andrewvh4/GPSClock_Hardware/README.md

# GPSClock_Hardware
A modular design for a GPS clock featuring a processor board to recieve and parse GPS data, and a display board to output the time.
