andrewvh4/GPSClock_Hardware/Documentation/Schematics/Binary Display Schematic.pdf

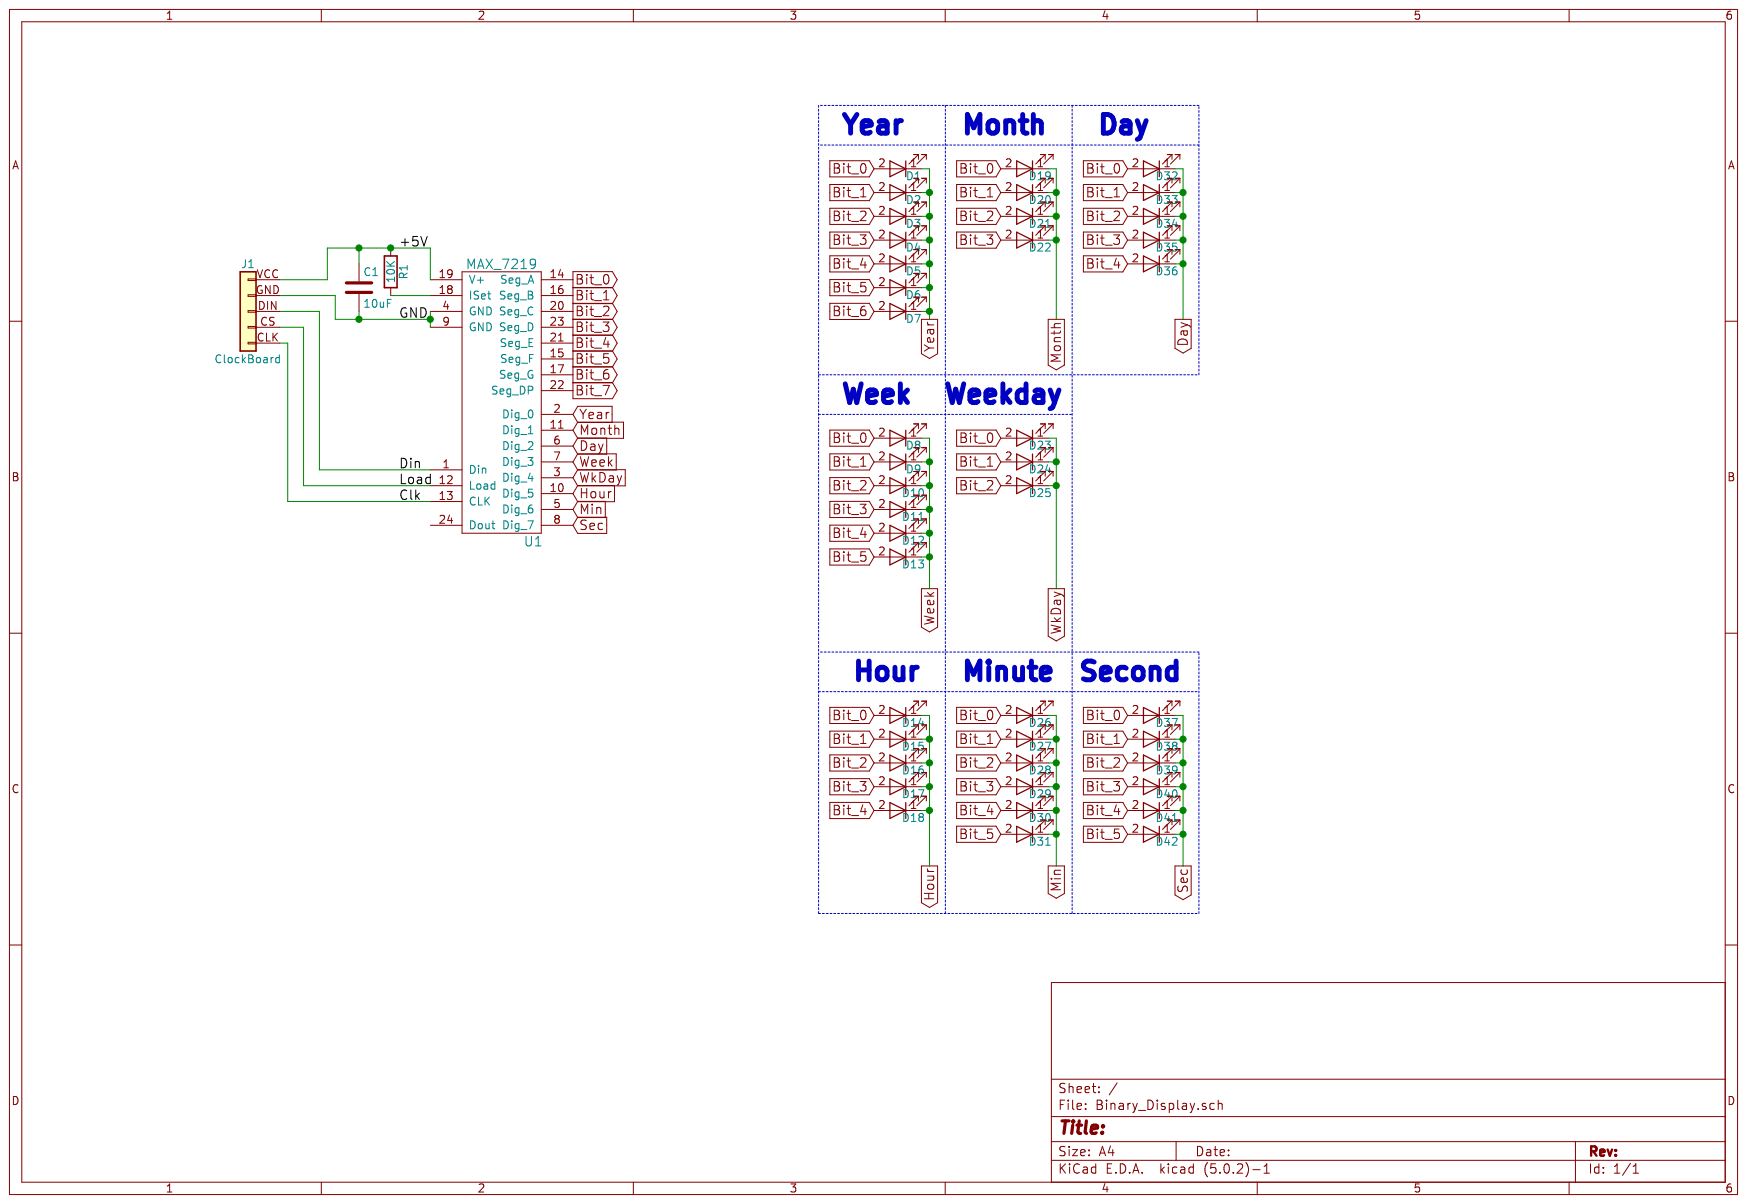
[picture p1: page 1]
