andrewvh4/GPSClock_Hardware/Documentation/Schematics/Clock Board Schematic.pdf

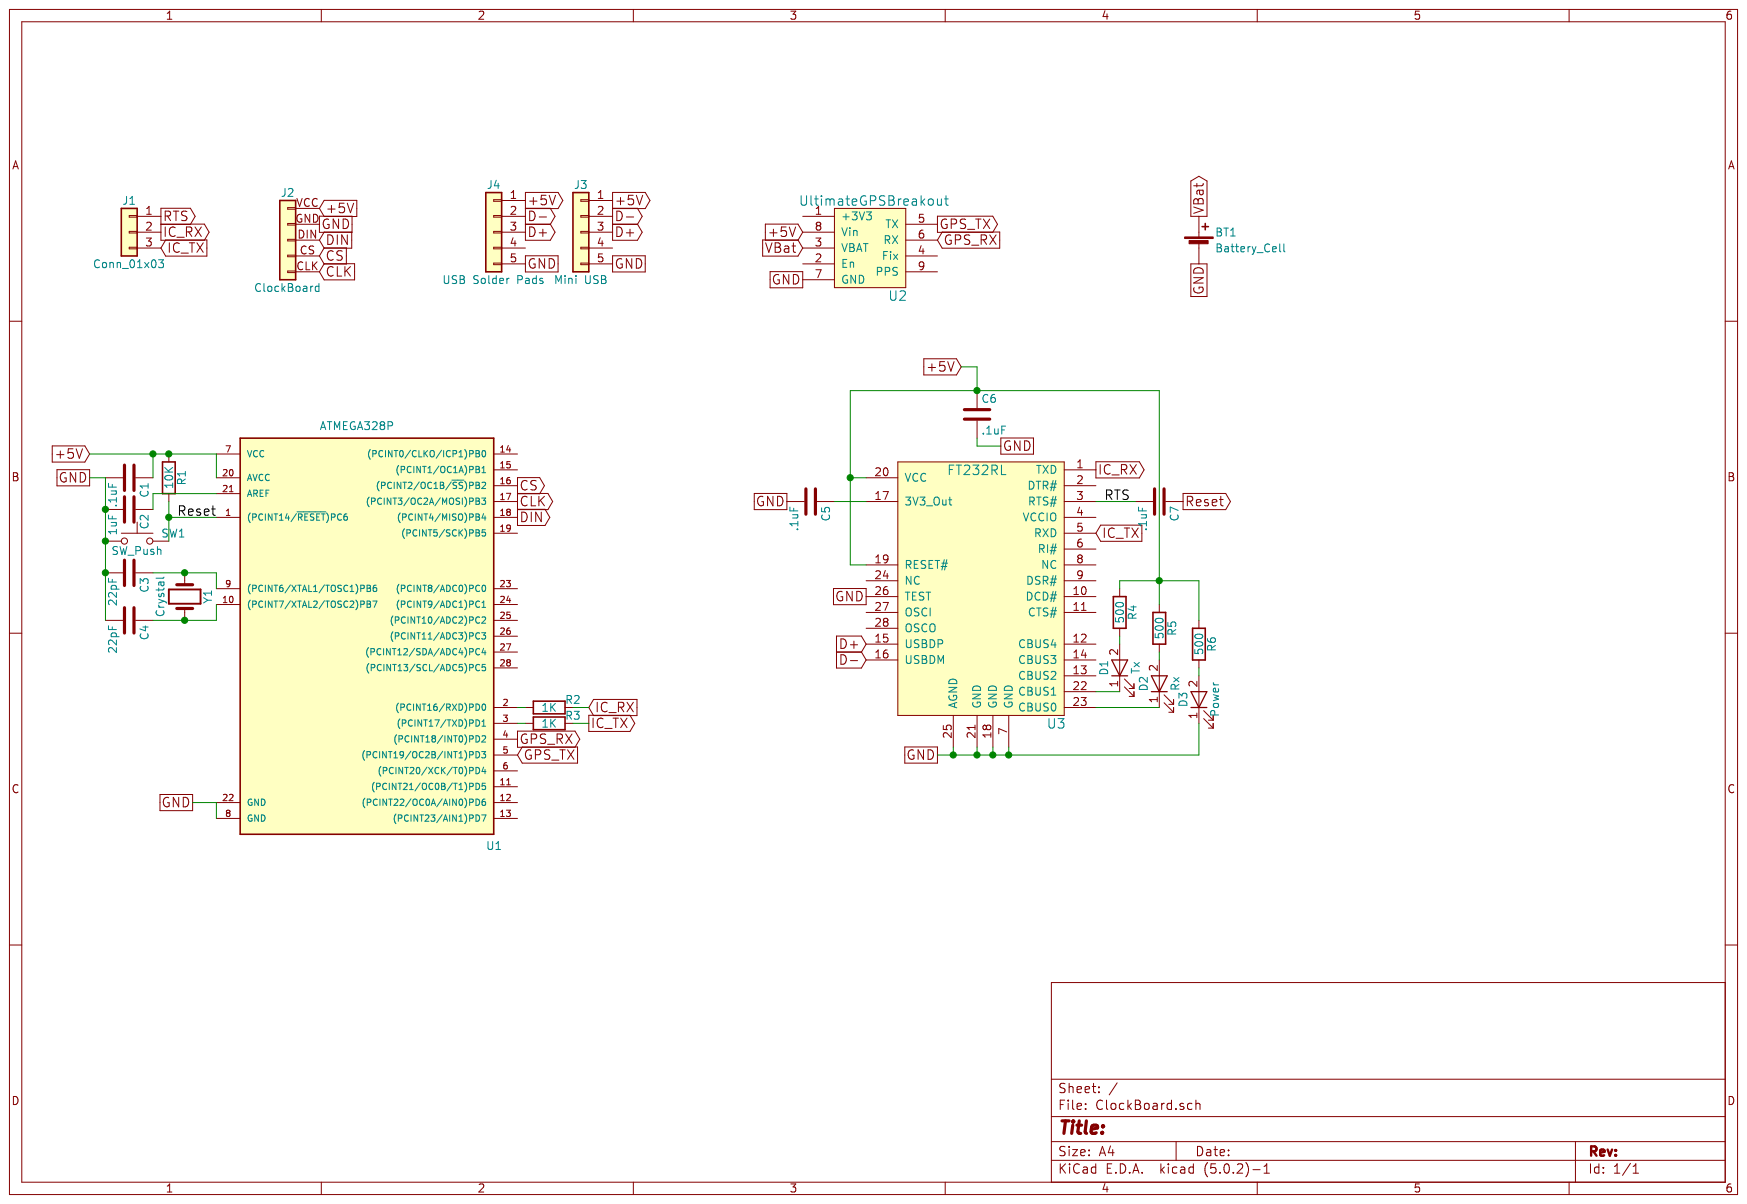
[picture p2: page 1]
