andrewvh4/GPSClock_Hardware/Documentation/Schematics/Conventional Display Schematic.pdf

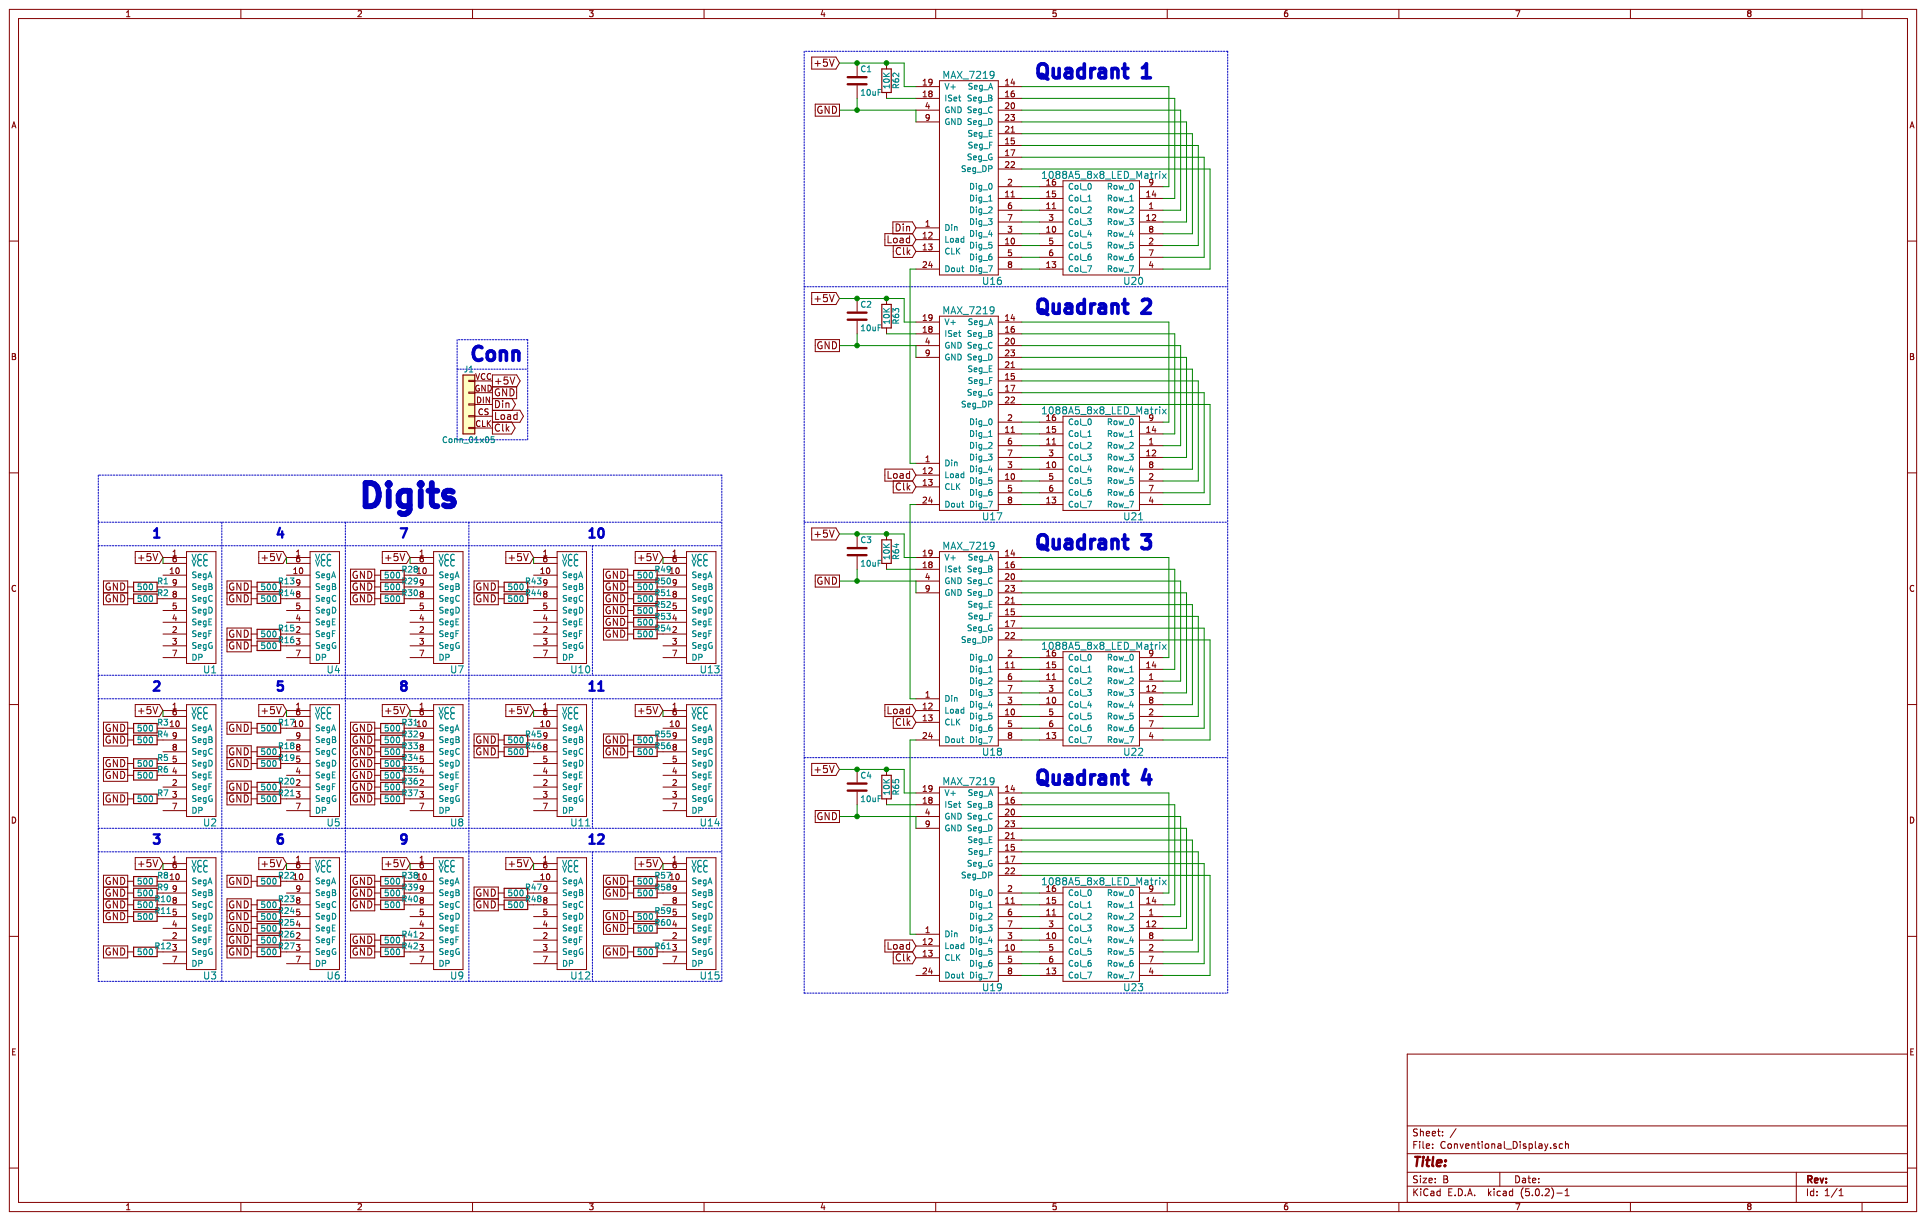
[picture p3: page 1]
