andrewvh4/GPSClock_Hardware/Conventional_Display/Conventional_Display.kicad_pcb

## KiCad design Conventional_Display/Conventional_Display.kicad_pcb (2020-06-09)

Schematic: Conventional_Display.sch

Parts:
C1, C2, C3, C4: 10uF; C_0603_HandSoldering
J1: Conn_01x05; Clock_Board
R1, R2, R3, R4, R5, R6, R7, R8, R9, R10, R11, R12, R13, R14, R15, R16, R17, R18, R19, R20, R21, R22, R23, R24, R25, R26, R27, R28, R29, R30, R31, R32, R33, R34, R35, R36, R37, R38, R39, R40, R41, R42, R43, R44, R45, R46, R47, R48, R49, R50, R51, R52, R53, R54, R55, R56, R57, R58, R59, R60, R61: 500; R_0603_HandSoldering
R62, R63, R64, R65: 10K; R_0603_HandSoldering
U1, U2, U3, U4, U5, U6, U7, U8, U9, U10, U11, U12, U13, U14, U15: 7-Segment_Display_CA; LSH-A101
U16, U17, U18, U19: MAX_7219; SOIC-24W_7.5x15.4mm_Pitch1.27mm
U20, U21, U22, U23: 1088A5_8x8_LED_Matrix; 1088A5_8x8matrix

Connections:
+5V: C1.1, C2.1, C3.1, C4.1, J1.VCC, R62.1, R63.1, R64.1, R65.1, U1.1, U1.6, U2.1, U2.6, U3.1, U3.6, U4.1, U4.6, U5.1, U5.6, U6.1, U6.6, U7.1, U7.6, U8.1, U8.6, U9.1, U9.6, U10.1, U10.6, U11.1, U11.6, U12.1, U12.6, U13.1, U13.6, U14.1, U14.6, U15.1, U15.6, U16.19 (V+), U17.19 (V+), U18.19 (V+), U19.19 (V+)
Clk: J1.CLK, U16.13 (CLK), U17.13 (CLK), U18.13 (CLK), U19.13 (CLK)
Din: J1.DIN, U16.1 (Din)
GND: C1.2, C2.2, C3.2, C4.2, J1.GND, R1.2, R2.2, R3.2, R4.2, R5.2, R6.2, R7.2, R8.2, R9.2, R10.2, R11.2, R12.2, R13.2, R14.2, R15.2, R16.2, R17.2, R18.2, R19.2, R20.2, R21.2, R22.2, R23.2, R24.2, R25.2, R26.2, R27.2, R28.2, R29.2, R30.2, R31.2, R32.2, R33.2, R34.2, R35.2, R36.2, R37.2, R38.2, R39.2, R40.2, R41.2, R42.2, R43.2, R44.2, R45.2, R46.2, R47.2, R48.2, R49.2, R50.2, R51.2, R52.2, R53.2, R54.2, R55.2, R56.2, R57.2, R58.2, R59.2, R60.2, R61.2, U16.4 (GND), U16.9 (GND), U17.4 (GND), U17.9 (GND), U18.4 (GND), U18.9 (GND), U19.4 (GND), U19.9 (GND)
Load: J1.CS, U16.12 (Load), U17.12 (Load), U18.12 (Load), U19.12 (Load)
unnamed: R1.1, U1.9
unnamed: R2.1, U1.8
unnamed: R3.1, U2.10
unnamed: R4.1, U2.9
unnamed: R5.1, U2.5
unnamed: R6.1, U2.4
unnamed: R7.1, U2.3
unnamed: R8.1, U3.10
unnamed: R9.1, U3.9
unnamed: R10.1, U3.8
unnamed: R11.1, U3.5
unnamed: R12.1, U3.3
unnamed: R13.1, U4.9
unnamed: R14.1, U4.8
unnamed: R15.1, U4.2
unnamed: R16.1, U4.3
unnamed: R17.1, U5.10
unnamed: R18.1, U5.8
unnamed: R19.1, U5.5
unnamed: R20.1, U5.2
unnamed: R21.1, U5.3
unnamed: R22.1, U6.10
unnamed: R23.1, U6.8
unnamed: R24.1, U6.5
unnamed: R25.1, U6.4
unnamed: R26.1, U6.2
unnamed: R27.1, U6.3
unnamed: R28.1, U7.10
unnamed: R29.1, U7.9
unnamed: R30.1, U7.8
unnamed: R31.1, U8.10
unnamed: R32.1, U8.9
unnamed: R33.1, U8.8
unnamed: R34.1, U8.5
unnamed: R35.1, U8.4
unnamed: R36.1, U8.2
unnamed: R37.1, U8.3
unnamed: R38.1, U9.10
unnamed: R39.1, U9.9
unnamed: R40.1, U9.8
unnamed: R41.1, U9.2
unnamed: R42.1, U9.3
unnamed: R43.1, U10.9
unnamed: R44.1, U10.8
unnamed: R45.1, U11.9
unnamed: R46.1, U11.8
unnamed: R47.1, U12.9
unnamed: R48.1, U12.8
unnamed: R49.1, U13.10
unnamed: R50.1, U13.9
unnamed: R51.1, U13.8
unnamed: R52.1, U13.5
unnamed: R53.1, U13.4
unnamed: R54.1, U13.2
unnamed: R55.1, U14.9
unnamed: R56.1, U14.8
unnamed: R57.1, U15.10
unnamed: R58.1, U15.9
unnamed: R59.1, U15.5
unnamed: R60.1, U15.4
unnamed: R61.1, U15.3
unnamed: R62.2, U16.18 (ISet)
unnamed: R63.2, U17.18 (ISet)
unnamed: R64.2, U18.18 (ISet)
unnamed: R65.2, U19.18 (ISet)
unnamed: U16.2 (Dig_0), U20.1 (Row_0)
unnamed: U16.3 (Dig_4), U20.9 (Row_4)
unnamed: U16.5 (Dig_6), U20.10 (Row_6)
unnamed: U16.6 (Dig_2), U20.16 (Row_2)
unnamed: U16.7 (Dig_3), U20.4 (Row_3)
unnamed: U16.8 (Dig_7), U20.13 (Row_7)
unnamed: U16.10 (Dig_5), U20.15 (Row_5)
unnamed: U16.11 (Dig_1), U20.6 (Row_1)
unnamed: U16.14 (Seg_A), U20.11 (Col_1)
unnamed: U16.15 (Seg_F), U20.7 (Col_6)
unnamed: U16.16 (Seg_B), U20.12 (Col_2)
unnamed: U16.17 (Seg_G), U20.8 (Col_7)
unnamed: U16.20 (Seg_C), U20.2 (Col_3)
unnamed: U16.21 (Seg_E), U20.3 (Col_5)
unnamed: U16.22 (Seg_DP), U20.5 (Col_0)
unnamed: U16.23 (Seg_D), U20.14 (Col_4)
unnamed: U16.24 (Dout), U17.1 (Din)
unnamed: U17.2 (Dig_0), U21.1 (Row_0)
unnamed: U17.3 (Dig_4), U21.9 (Row_4)
unnamed: U17.5 (Dig_6), U21.10 (Row_6)
unnamed: U17.6 (Dig_2), U21.16 (Row_2)
unnamed: U17.7 (Dig_3), U21.4 (Row_3)
unnamed: U17.8 (Dig_7), U21.13 (Row_7)
unnamed: U17.10 (Dig_5), U21.15 (Row_5)
unnamed: U17.11 (Dig_1), U21.6 (Row_1)
unnamed: U17.14 (Seg_A), U21.11 (Col_1)
unnamed: U17.15 (Seg_F), U21.7 (Col_6)
unnamed: U17.16 (Seg_B), U21.12 (Col_2)
unnamed: U17.17 (Seg_G), U21.8 (Col_7)
unnamed: U17.20 (Seg_C), U21.2 (Col_3)
unnamed: U17.21 (Seg_E), U21.3 (Col_5)
unnamed: U17.22 (Seg_DP), U21.5 (Col_0)
unnamed: U17.23 (Seg_D), U21.14 (Col_4)
unnamed: U17.24 (Dout), U18.1 (Din)
unnamed: U18.2 (Dig_0), U22.1 (Row_0)
unnamed: U18.3 (Dig_4), U22.9 (Row_4)
unnamed: U18.5 (Dig_6), U22.10 (Row_6)
unnamed: U18.6 (Dig_2), U22.16 (Row_2)
unnamed: U18.7 (Dig_3), U22.4 (Row_3)
unnamed: U18.8 (Dig_7), U22.13 (Row_7)
unnamed: U18.10 (Dig_5), U22.15 (Row_5)
unnamed: U18.11 (Dig_1), U22.6 (Row_1)
unnamed: U18.14 (Seg_A), U22.11 (Col_1)
unnamed: U18.15 (Seg_F), U22.7 (Col_6)
unnamed: U18.16 (Seg_B), U22.12 (Col_2)
unnamed: U18.17 (Seg_G), U22.8 (Col_7)
unnamed: U18.20 (Seg_C), U22.2 (Col_3)
unnamed: U18.21 (Seg_E), U22.3 (Col_5)
unnamed: U18.22 (Seg_DP), U22.5 (Col_0)
unnamed: U18.23 (Seg_D), U22.14 (Col_4)
unnamed: U18.24 (Dout), U19.1 (Din)
unnamed: U19.2 (Dig_0), U23.1 (Row_0)
unnamed: U19.3 (Dig_4), U23.9 (Row_4)
unnamed: U19.5 (Dig_6), U23.10 (Row_6)
unnamed: U19.6 (Dig_2), U23.16 (Row_2)
unnamed: U19.7 (Dig_3), U23.4 (Row_3)
unnamed: U19.8 (Dig_7), U23.13 (Row_7)
unnamed: U19.10 (Dig_5), U23.15 (Row_5)
unnamed: U19.11 (Dig_1), U23.6 (Row_1)
unnamed: U19.14 (Seg_A), U23.11 (Col_1)
unnamed: U19.15 (Seg_F), U23.7 (Col_6)
unnamed: U19.16 (Seg_B), U23.12 (Col_2)
unnamed: U19.17 (Seg_G), U23.8 (Col_7)
unnamed: U19.20 (Seg_C), U23.2 (Col_3)
unnamed: U19.21 (Seg_E), U23.3 (Col_5)
unnamed: U19.22 (Seg_DP), U23.5 (Col_0)
unnamed: U19.23 (Seg_D), U23.14 (Col_4)

Notes on the sheet:
Quadrant 1
Quadrant 2
Quadrant 3
Quadrant 4
Digits
Conn

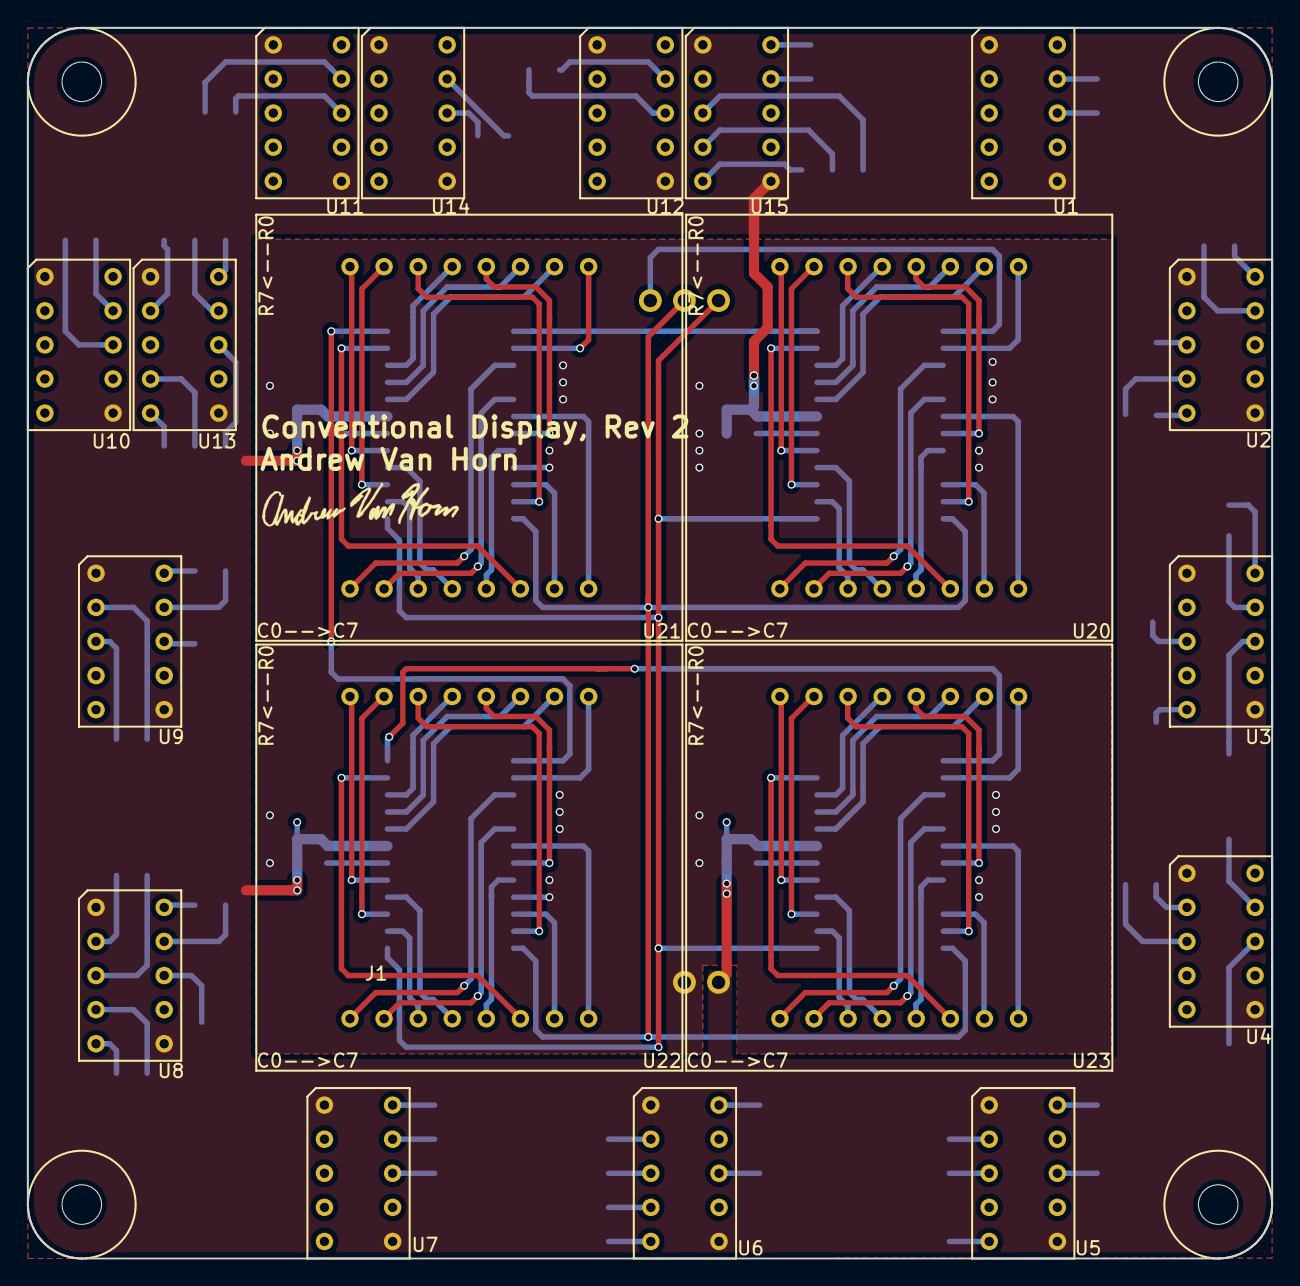
[picture p4: board Conventional_Display.kicad_pcb from above]

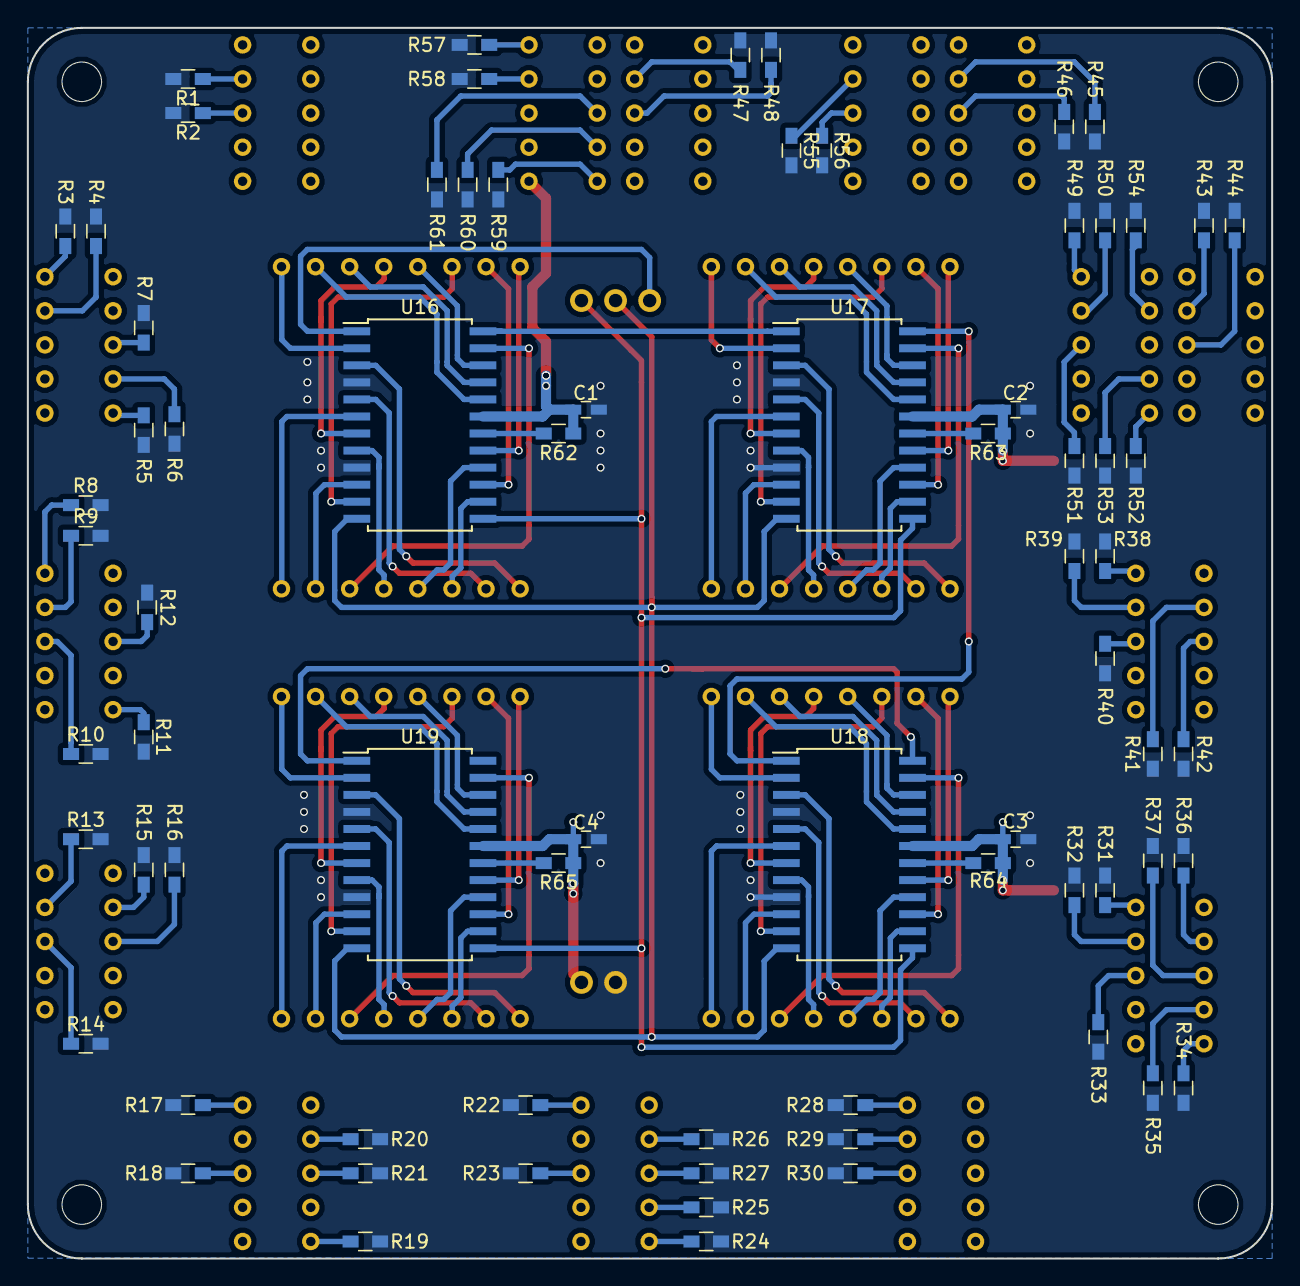
[picture p5: board Conventional_Display.kicad_pcb from below]

Board: 2 copper layers, 92.7 x 91.7 mm, 93 parts (73 on the bottom side), 137 nets.
