andrewvh4/GPSClock_Hardware/Binary_Display/Binary_Display.kicad_pcb

## KiCad design Binary_Display/Binary_Display.kicad_pcb (2020-06-01)

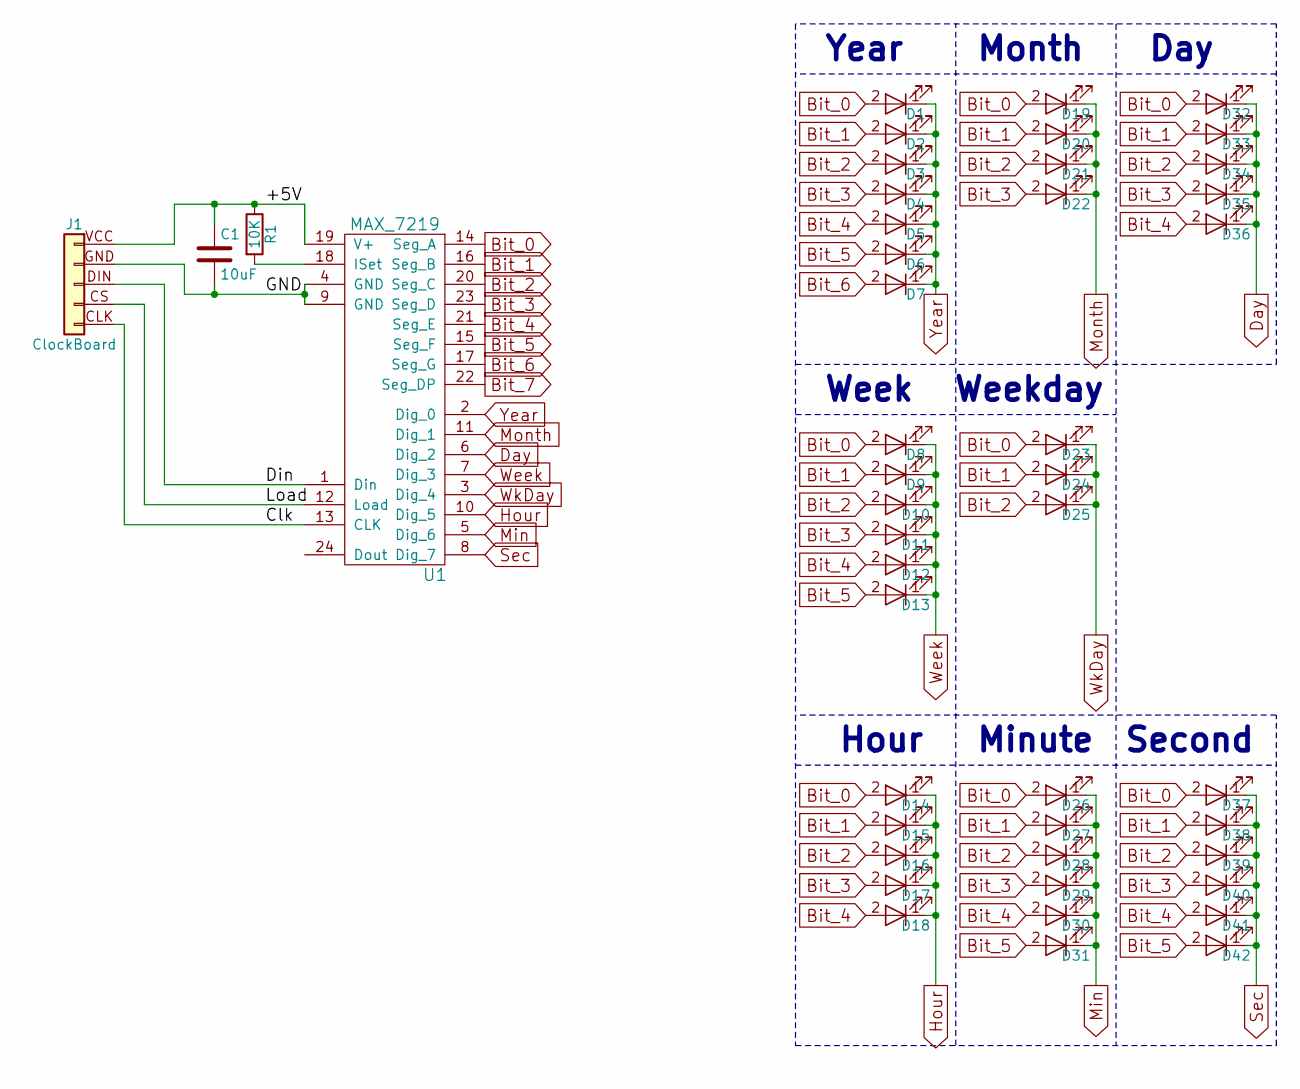
[picture p6: schematic Binary_Display.sch]

Parts:
C1: 10uF; C_0603_HandSoldering
D1, D2, D3, D4, D5, D6, D7, D8, D9, D10, D11, D12, D13, D14, D15, D16, D17, D18, D19, D20, D21, D22, D23, D24, D25, D26, D27, D28, D29, D30, D31, D32, D33, D34, D35, D36, D37, D38, D39, D40, D41, D42: LED; LED_D5.0mm
J1: ClockBoard; Clock_Board
R1: 10K; R_0603_HandSoldering
U1: MAX_7219; SOIC-24W_7.5x15.4mm_Pitch1.27mm

Connections:
/+5V: C1.1, J1.VCC (Pin_1), R1.1, U1.19 (V+)
/Clk: J1.CLK (Pin_5), U1.13 (CLK)
/Din: J1.DIN (Pin_3), U1.1 (Din)
/GND: C1.2, J1.GND (Pin_2), U1.4 (GND), U1.9 (GND)
/Load: J1.CS (Pin_4), U1.12 (Load)
Bit_0: D1.2 (A), D8.2 (A), D14.2 (A), D19.2 (A), D23.2 (A), D26.2 (A), D32.2 (A), D37.2 (A), U1.14 (Seg_A)
Bit_1: D2.2 (A), D9.2 (A), D15.2 (A), D20.2 (A), D24.2 (A), D27.2 (A), D33.2 (A), D38.2 (A), U1.16 (Seg_B)
Bit_2: D3.2 (A), D10.2 (A), D16.2 (A), D21.2 (A), D25.2 (A), D28.2 (A), D34.2 (A), D39.2 (A), U1.20 (Seg_C)
Bit_3: D4.2 (A), D11.2 (A), D17.2 (A), D22.2 (A), D29.2 (A), D35.2 (A), D40.2 (A), U1.23 (Seg_D)
Bit_4: D5.2 (A), D12.2 (A), D18.2 (A), D30.2 (A), D36.2 (A), D41.2 (A), U1.21 (Seg_E)
Bit_5: D6.2 (A), D13.2 (A), D31.2 (A), D42.2 (A), U1.15 (Seg_F)
Bit_6: D7.2 (A), U1.17 (Seg_G)
Day: D32.1 (K), D33.1 (K), D34.1 (K), D35.1 (K), D36.1 (K), U1.6 (Dig_2)
Hour: D14.1 (K), D15.1 (K), D16.1 (K), D17.1 (K), D18.1 (K), U1.10 (Dig_5)
Min: D26.1 (K), D27.1 (K), D28.1 (K), D29.1 (K), D30.1 (K), D31.1 (K), U1.5 (Dig_6)
Month: D19.1 (K), D20.1 (K), D21.1 (K), D22.1 (K), U1.11 (Dig_1)
unnamed: R1.2, U1.18 (ISet)
Sec: D37.1 (K), D38.1 (K), D39.1 (K), D40.1 (K), D41.1 (K), D42.1 (K), U1.8 (Dig_7)
Week: D8.1 (K), D9.1 (K), D10.1 (K), D11.1 (K), D12.1 (K), D13.1 (K), U1.7 (Dig_3)
WkDay: D23.1 (K), D24.1 (K), D25.1 (K), U1.3 (Dig_4)
Year: D1.1 (K), D2.1 (K), D3.1 (K), D4.1 (K), D5.1 (K), D6.1 (K), D7.1 (K), U1.2 (Dig_0)

Notes on the sheet:
Year
Month
Day
Week
Weekday
Hour
Minute
Second

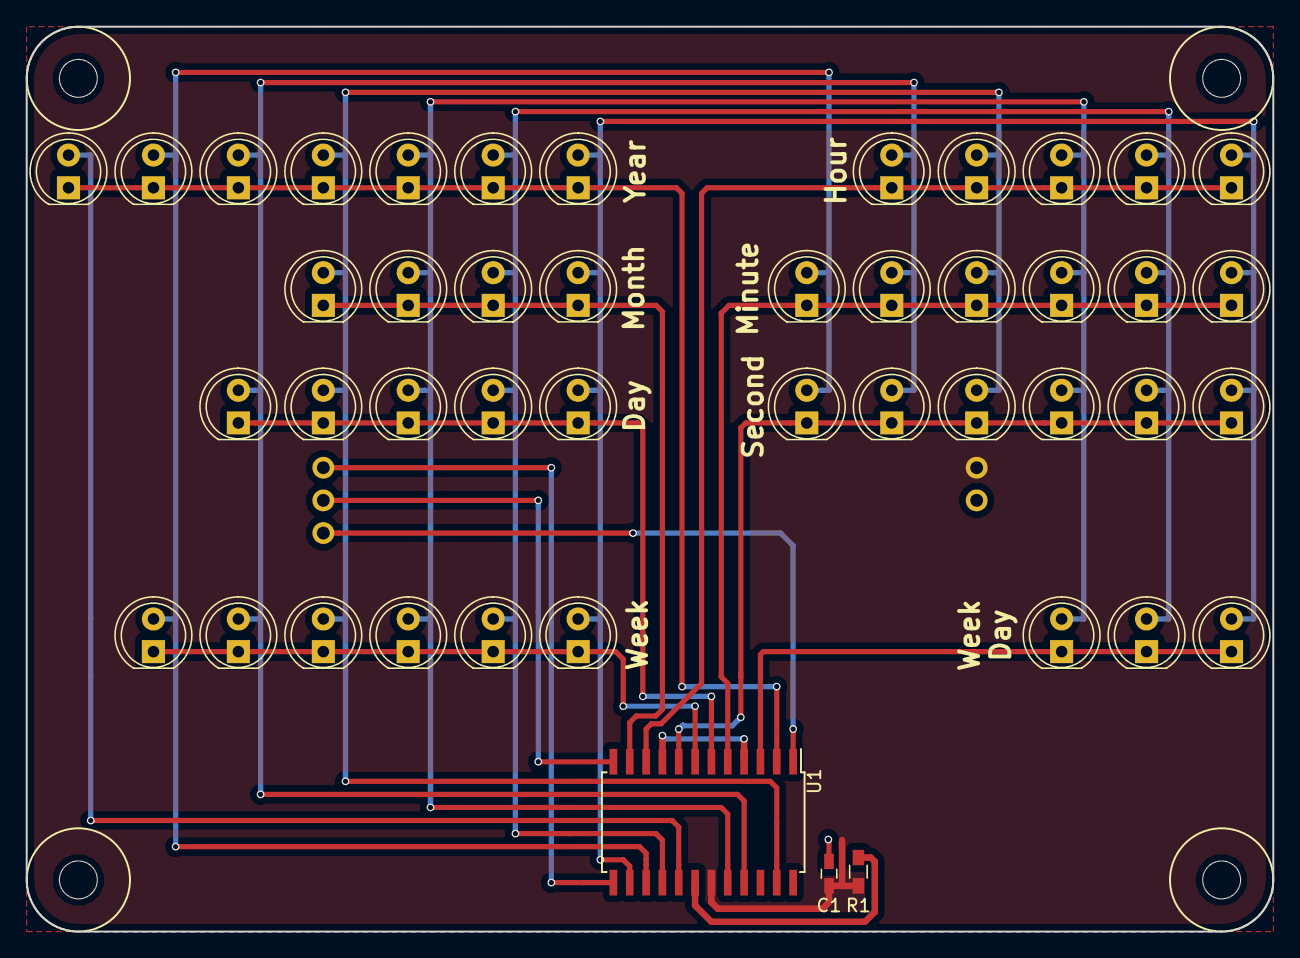
[picture p7: board Binary_Display.kicad_pcb from above]

Board: 2 copper layers, 96.9 x 70.4 mm, 46 parts (0 on the bottom side), 21 nets.
