andrewvh4/GPSClock_Hardware/ClockBoard/ClockBoard.kicad_pcb

## KiCad design ClockBoard/ClockBoard.kicad_pcb (2020-06-01)

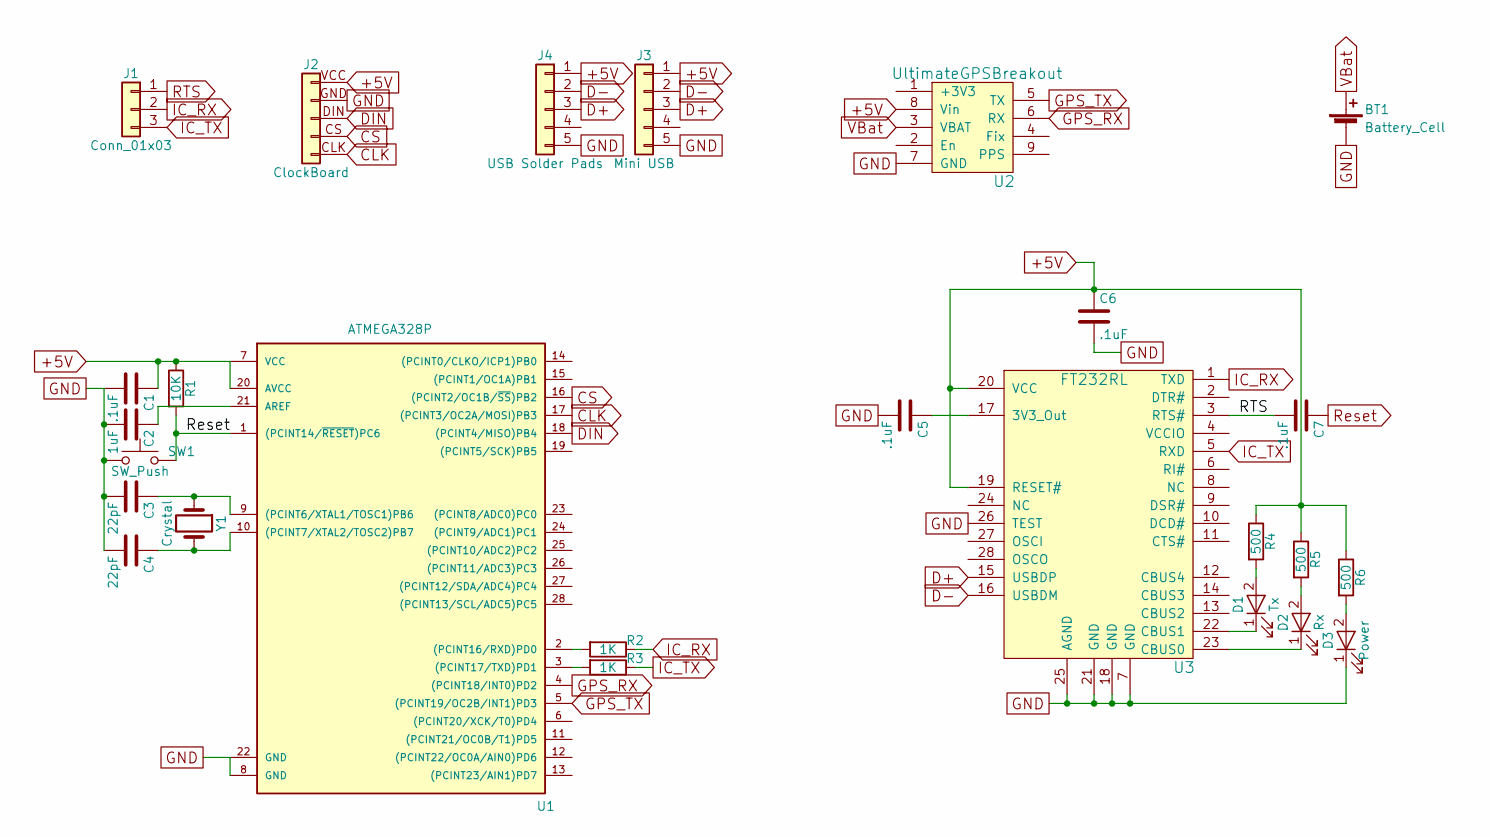
[picture p8: schematic ClockBoard.sch]

Parts:
BT1: Battery_Cell; CR1220_Battery_Holder
C1, C5, C6, C7: .1uF; C_0603_HandSoldering
C2: 1uF; C_0603_HandSoldering
C3, C4: 22pF; C_0603_HandSoldering
D1: Tx; D_0603
D2: Rx; D_0603
D3: Power; D_0603
J1: Conn_01x03; Pin_Header_Straight_1x03_Pitch2.54mm
J2: ClockBoard; Clock_Board
J3: Mini USB; MiniUSB_SMT
J4: USB Solder Pads; Pin_Header_Straight_1x05_Pitch2.54mm
R1: 10K; R_0603_HandSoldering
R2, R3: 1K; R_0603_HandSoldering
R4, R5, R6: 500; R_0603_HandSoldering
SW1: SW_Push; SPST_Pushbutton
U1: ATMEGA328P; DIP-28_W7.62mm
U2: UltimateGPSBreakout; Ultimate_GPS_Breakout
U3: FT232RL; SSOP-28_5.3x10.2mm_Pitch0.65mm
Y1: Crystal; Crystal_SMD_HC49-SD_HandSoldering

Connections:
+5V: C1.1, C6.1, J2.VCC (Pin_1), J3.1, J4.1, R1.1, R4.1, R5.1, R6.1, U1.7 (VCC), U1.20 (AVCC), U2.8 (Vin), U3.19 (RESET#), U3.20 (VCC)
CLK: J2.CLK (Pin_5), U1.17 ((PCINT3/OC2A/MOSI)PB3)
CS: J2.CS (Pin_4), U1.16 ((PCINT2/OC1B/~SS~)PB2)
D+: J3.3, J4.3, U3.15 (USBDP)
D-: J3.2, J4.2, U3.16 (USBDM)
DIN: J2.DIN (Pin_3), U1.18 ((PCINT4/MISO)PB4)
GND: BT1.2 (-), C1.2, C2.2, C3.2, C4.2, C5.2, C6.2, D3.1 (K), J2.GND (Pin_2), J3.5, J4.5, SW1.1, U1.8 (GND), U1.22 (GND), U2.7 (GND), U3.7 (GND), U3.18 (GND), U3.21 (GND), U3.25 (AGND), U3.26 (TEST)
GPS_RX: U1.4 ((PCINT18/INT0)PD2), U2.6 (RX)
GPS_TX: U1.5 ((PCINT19/OC2B/INT1)PD3), U2.5 (TX)
IC_RX: J1.2, R2.1, U3.1 (TXD)
IC_TX: J1.3, R3.1, U3.5 (RXD)
unnamed: C2.1, U1.21 (AREF)
unnamed: C3.1, U1.9 ((PCINT6/XTAL1/TOSC1)PB6), Y1.1
unnamed: C4.1, U1.10 ((PCINT7/XTAL2/TOSC2)PB7), Y1.2
unnamed: C5.1, U3.17 (3V3_Out)
unnamed: D1.1 (K), U3.22 (CBUS1)
unnamed: D1.2 (A), R4.2
unnamed: D2.1 (K), U3.23 (CBUS0)
unnamed: D2.2 (A), R5.2
unnamed: D3.2 (A), R6.2
unnamed: R2.2, U1.2 ((PCINT16/RXD)PD0)
unnamed: R3.2, U1.3 ((PCINT17/TXD)PD1)
RTS: C7.2, J1.1, U3.3 (RTS#)
Reset: C7.1, R1.2, SW1.2, U1.1 ((PCINT14/~RESET~)PC6)
VBat: BT1.1 (+), U2.3 (VBAT)

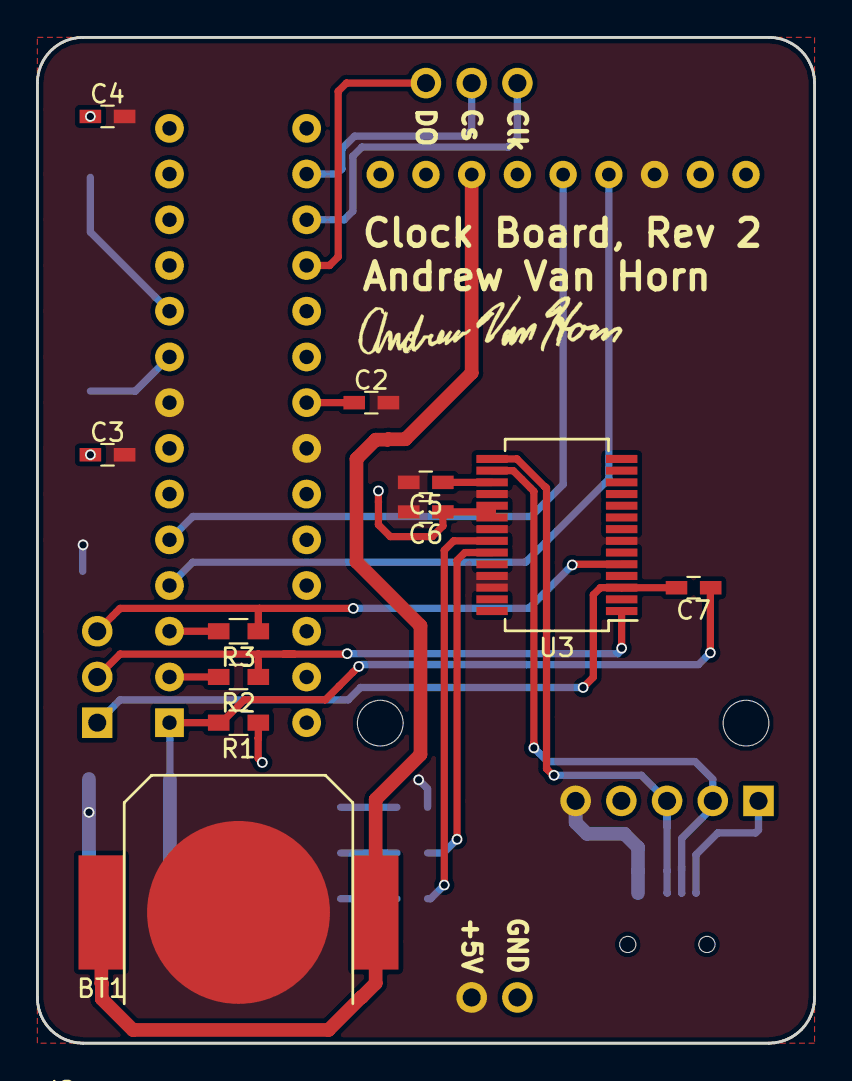
[picture p9: board ClockBoard.kicad_pcb from above]

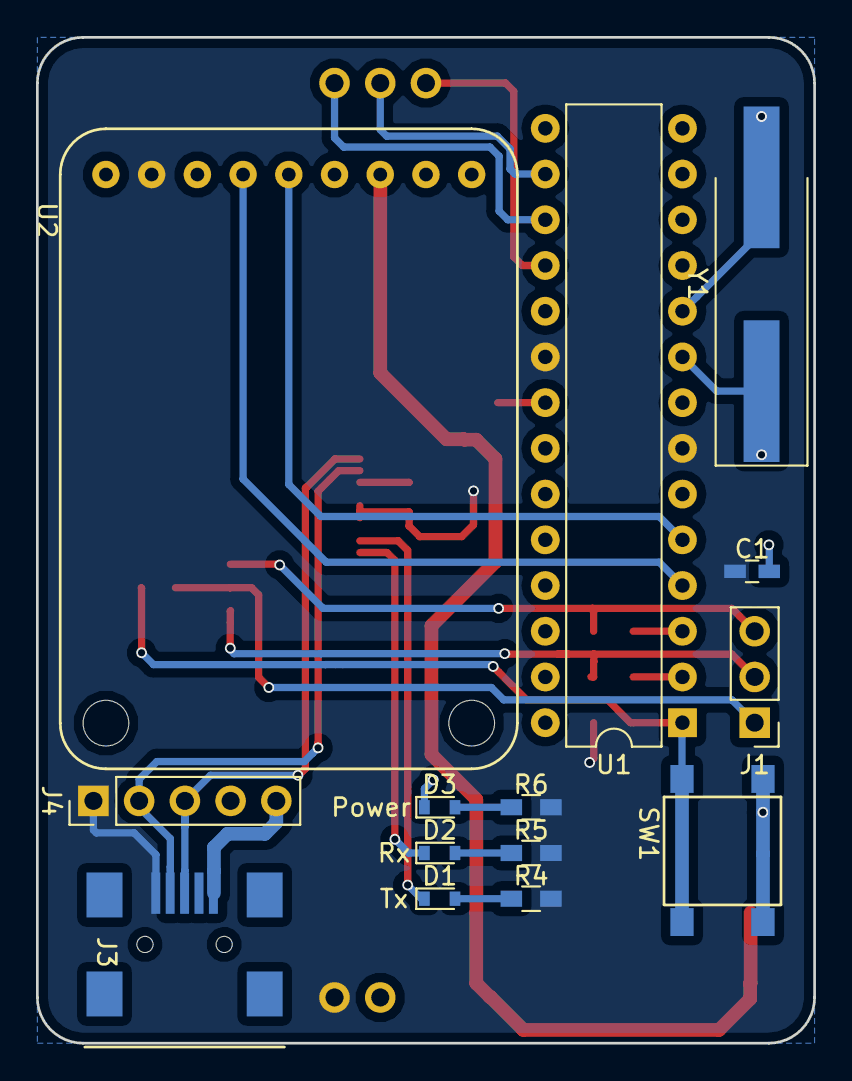
[picture p10: board ClockBoard.kicad_pcb from below]

Board: 2 copper layers, 43.2 x 55.9 mm, 26 parts (14 on the bottom side), 25 nets.
