andrewvh4/GPSClock_Hardware/(commit log)

2018-07-11 Board Design for Binary and Conventional Display
    [Binary_Display.kicad_pcb, Binary_Display.sch, ClockBoard.kicad_pcb, ClockBoard.sch, Clock_Controller.kicad_pcb, Clock_Controller.sch, Conventional_Display.kicad_pcb, Conventional_Display.sch]
2018-08-15 Created clock board
    [ClockBoard.kicad_pcb, ClockBoard.sch]
2018-08-18 Made Clock Board
    [Binary_Display.kicad_pcb, Binary_Display.sch, ClockBoard.kicad_pcb, ClockBoard.sch, Conventional_Display.kicad_pcb, Conventional_Display.sch]
2018-08-29 Removed Had Display
    [Hand_Display.kicad_pcb, Hand_Display.sch]
2018-08-29 Removed Unnecesary Files
    [Clock_Controller.kicad_pcb, Clock_Controller.sch]
2018-10-05 generated Gerbs
    [Binary_Display-B.Cu.gbr, Binary_Display-B.Mask.gbr, Binary_Display-B.Paste.gbr, Binary_Display-B.SilkS.gbr, Binary_Display-Edge.Cuts.gbr, Binary_Display-F.Cu.gbr, Binary_Display-F.Mask.gbr, Binary_Display-F.Paste.gbr]
2020-06-01 Created BOM for all boards
    [Binary_Display_BOM.csv, ClockBoard_BOM.csv, Conventional_Display_BOM.csv]
2020-06-01 Added silkscreen to boards and organized gerbs
    [Binary_Display-B.Cu.gbr, Binary_Display-B.Mask.gbr, Binary_Display-B.Paste.gbr, Binary_Display-B.SilkS.gbr, Binary_Display-Edge.Cuts.gbr, Binary_Display-F.Cu.gbr, Binary_Display-F.Mask.gbr, Binary_Display-F.Paste.gbr]
2020-06-09 re routed conventional display LED matrix traces.
    [Conventional_Display-B.Cu.gbr, Conventional_Display-B.Mask.gbr, Conventional_Display-B.Paste.gbr, Conventional_Display-B.SilkS.gbr, Conventional_Display-Edge.Cuts.gbr, Conventional_Display-F.Cu.gbr, Conventional_Display-F.Mask.gbr, Conventional_Display-F.Paste.gbr]
